jeanmoroski/Amazonian/tmp_imagens/exp02_a.jpg

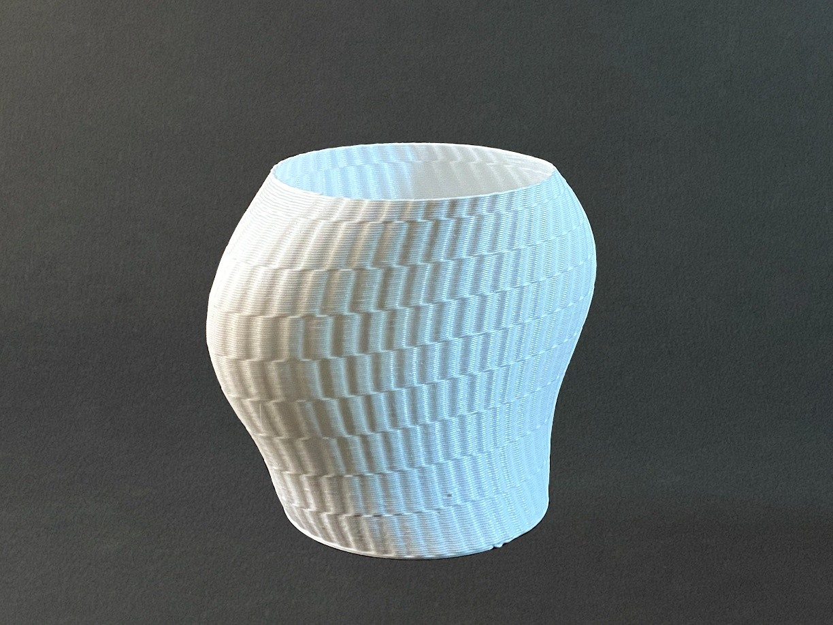
tmp_imagens/exp02_a.jpg
