jeanmoroski/Amazonian/tmp_imagens/exp13_a.jpg

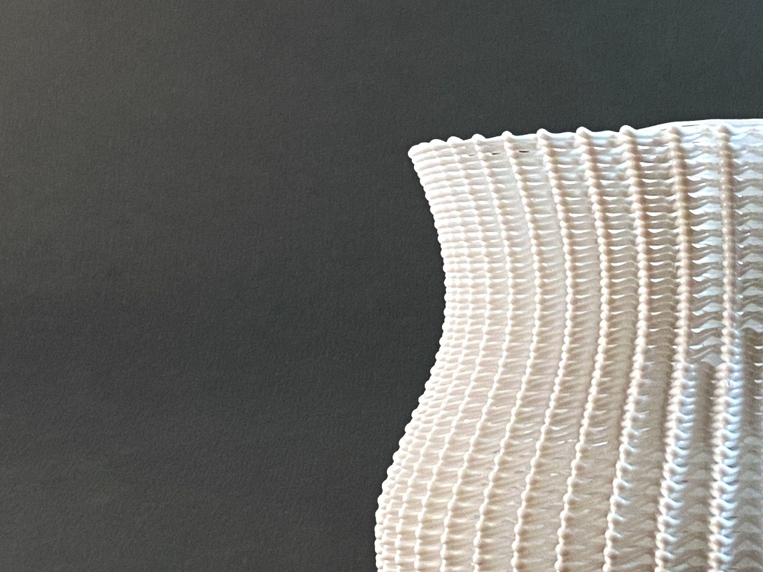
tmp_imagens/exp13_a.jpg
