jeanmoroski/Amazonian/tmp_imagens/exp01_a.jpg

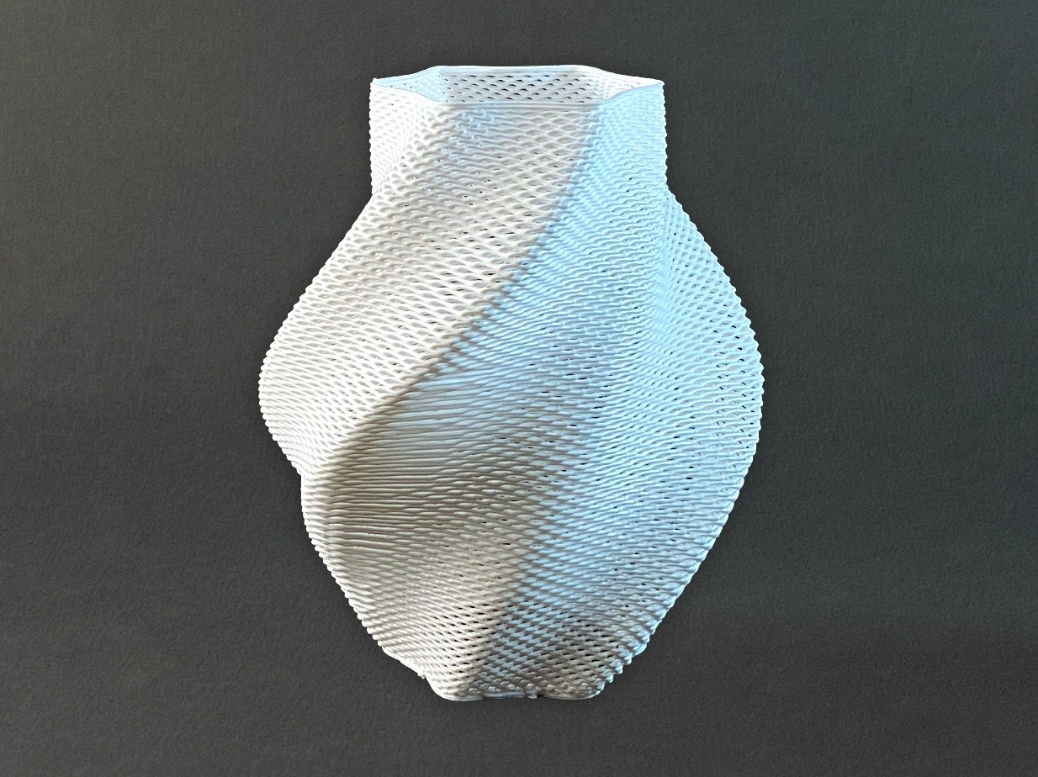
tmp_imagens/exp01_a.jpg
