jeanmoroski/Amazonian/tmp_imagens/exp01_b.jpg

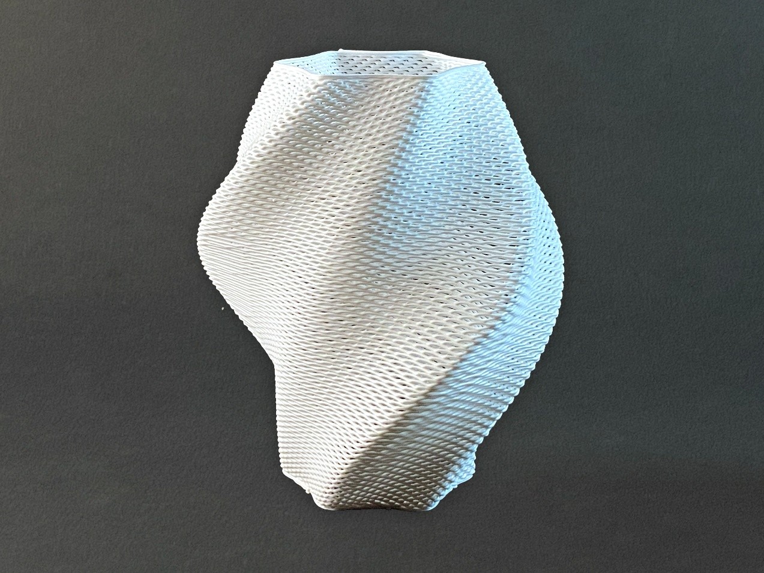
tmp_imagens/exp01_b.jpg
