jeanmoroski/Amazonian/tmp_imagens/exp02_b.jpg

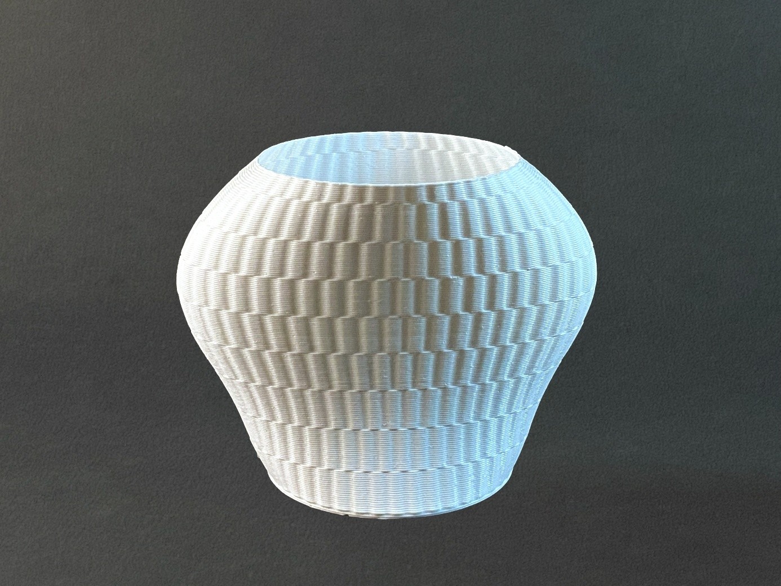
tmp_imagens/exp02_b.jpg
