jeanmoroski/Amazonian/tmp_imagens/exp03_a.jpg

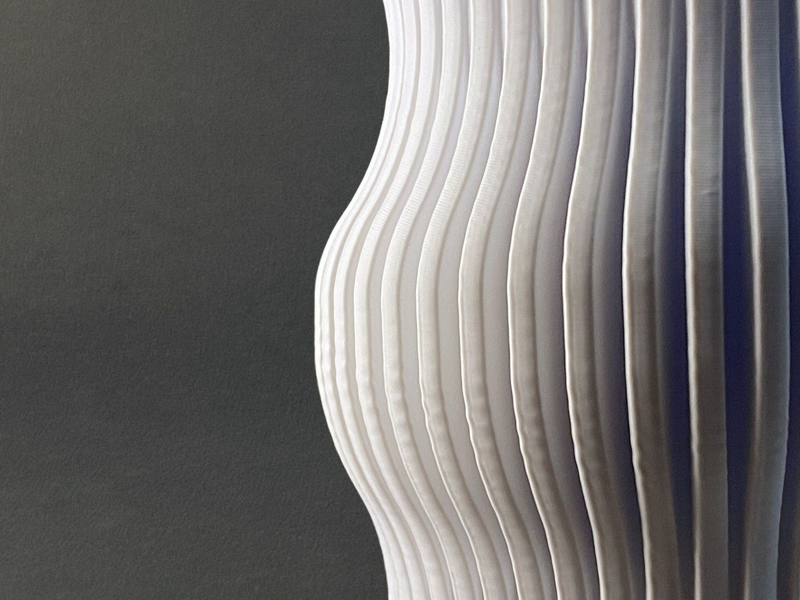
tmp_imagens/exp03_a.jpg
