jeanmoroski/Amazonian/tmp_imagens/exp03_b.jpg

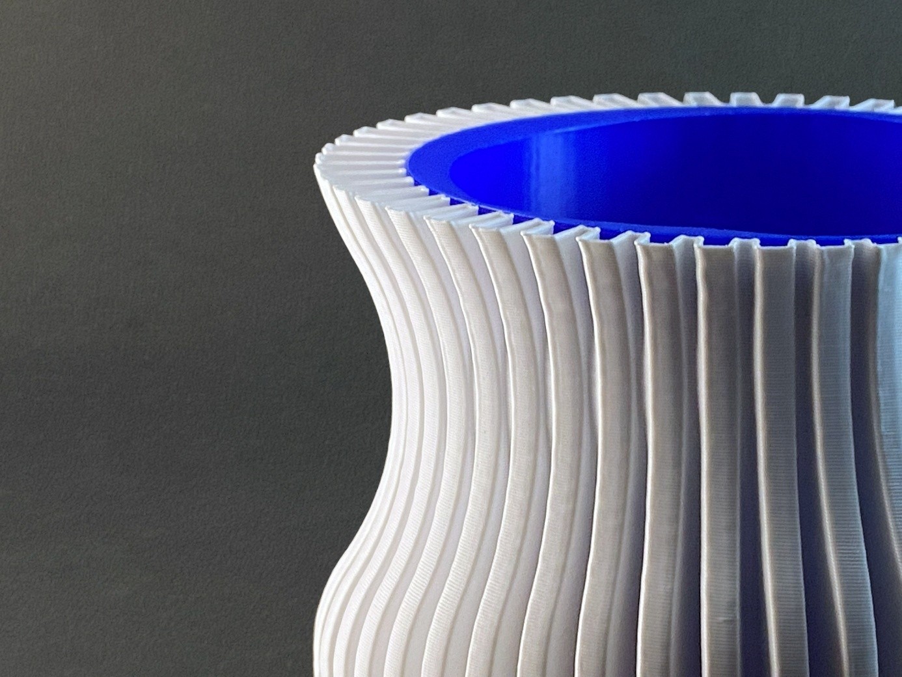
tmp_imagens/exp03_b.jpg
