jeanmoroski/Amazonian/tmp_imagens/exp04_a.jpg

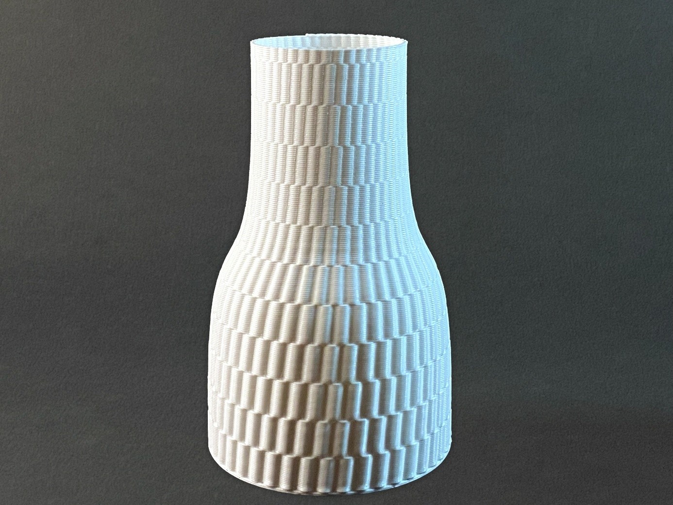
tmp_imagens/exp04_a.jpg
