jeanmoroski/Amazonian/tmp_imagens/exp05_a.jpg

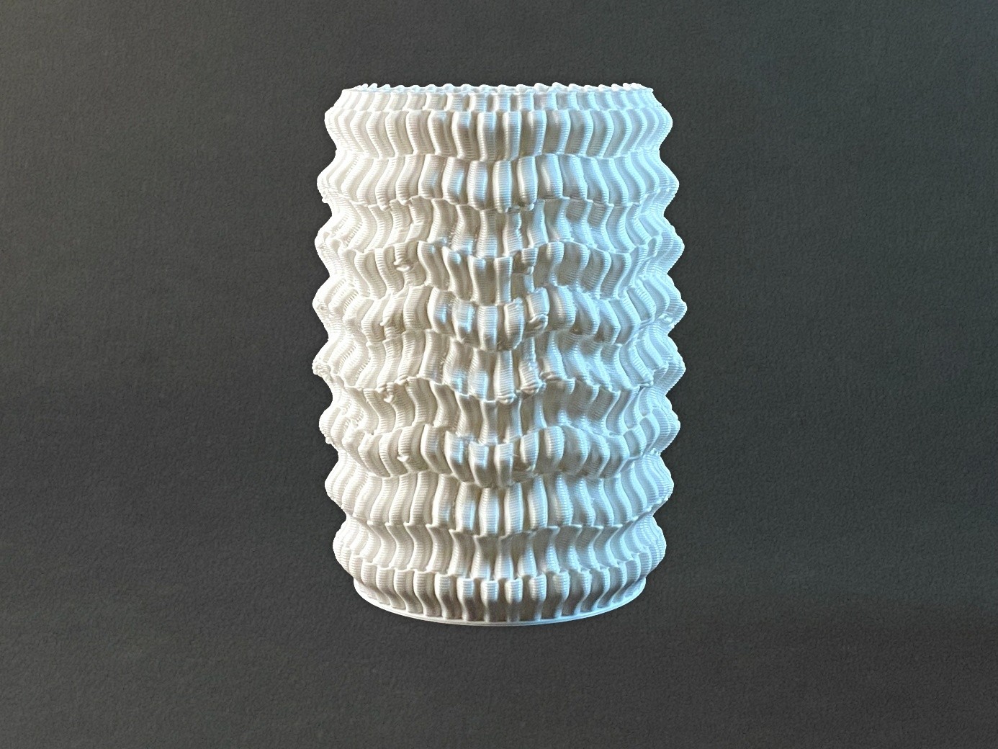
tmp_imagens/exp05_a.jpg
