jeanmoroski/Amazonian/tmp_imagens/exp06_a.jpg

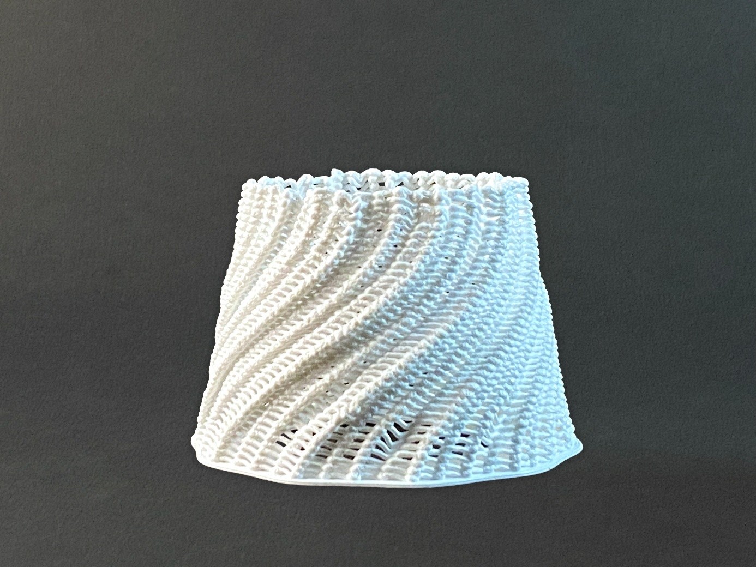
tmp_imagens/exp06_a.jpg
