jeanmoroski/Amazonian/tmp_imagens/exp07_a.jpg

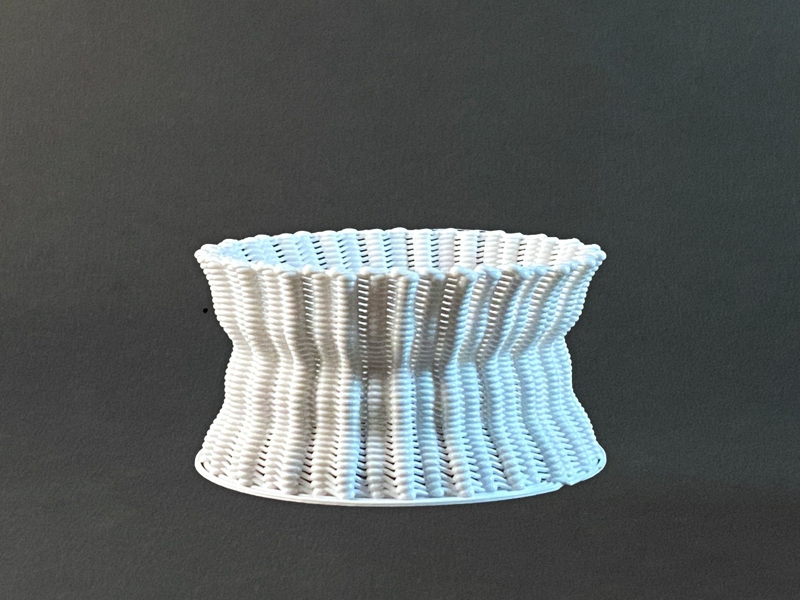
tmp_imagens/exp07_a.jpg
