jeanmoroski/Amazonian/tmp_imagens/exp08_a.jpg

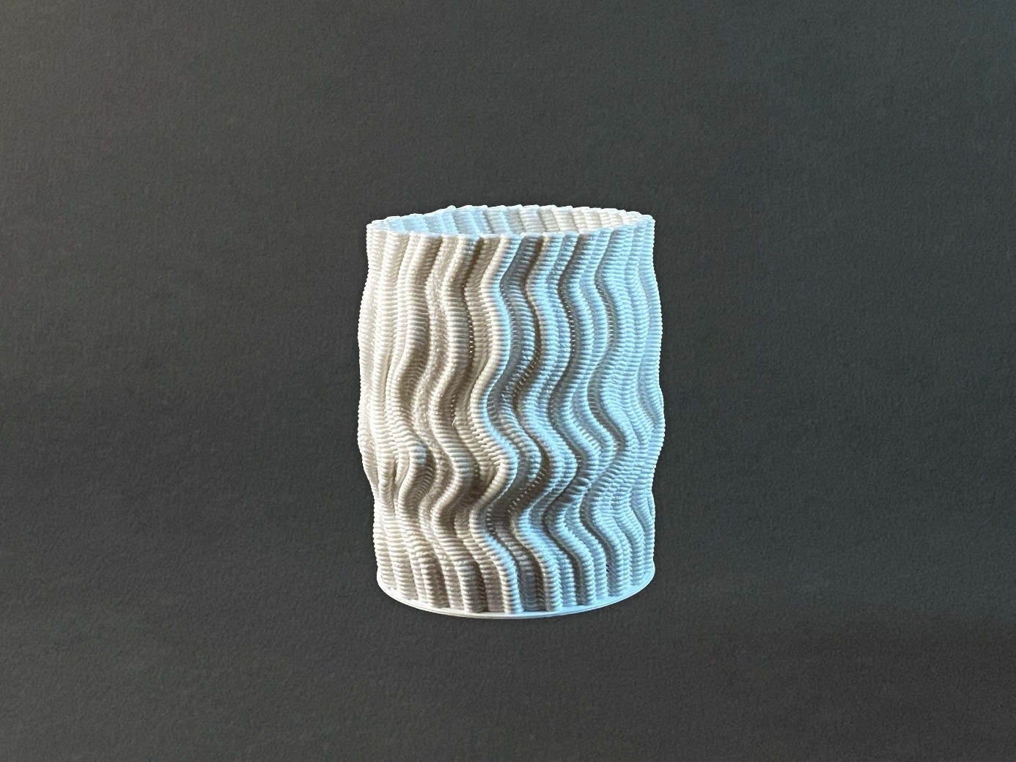
tmp_imagens/exp08_a.jpg
