jeanmoroski/Amazonian/tmp_imagens/exp09_a.jpg

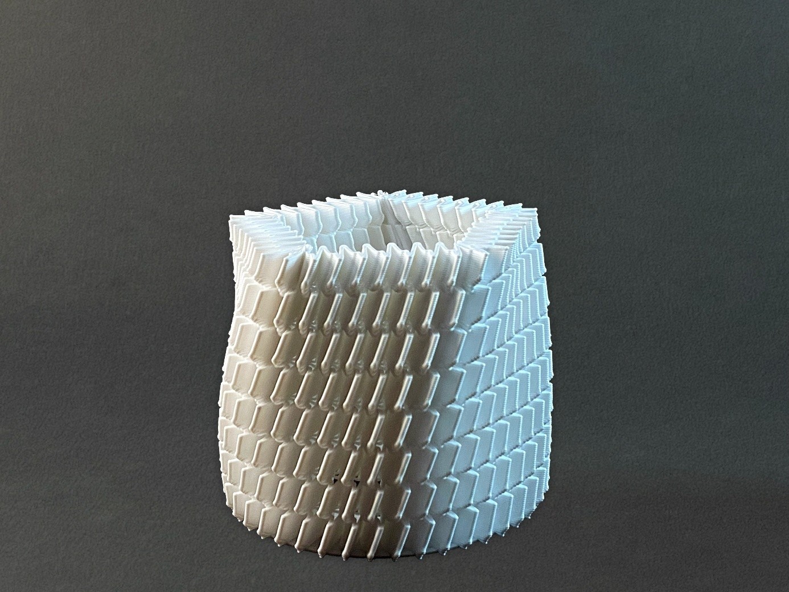
tmp_imagens/exp09_a.jpg
