jeanmoroski/Amazonian/tmp_imagens/exp10_a.jpg

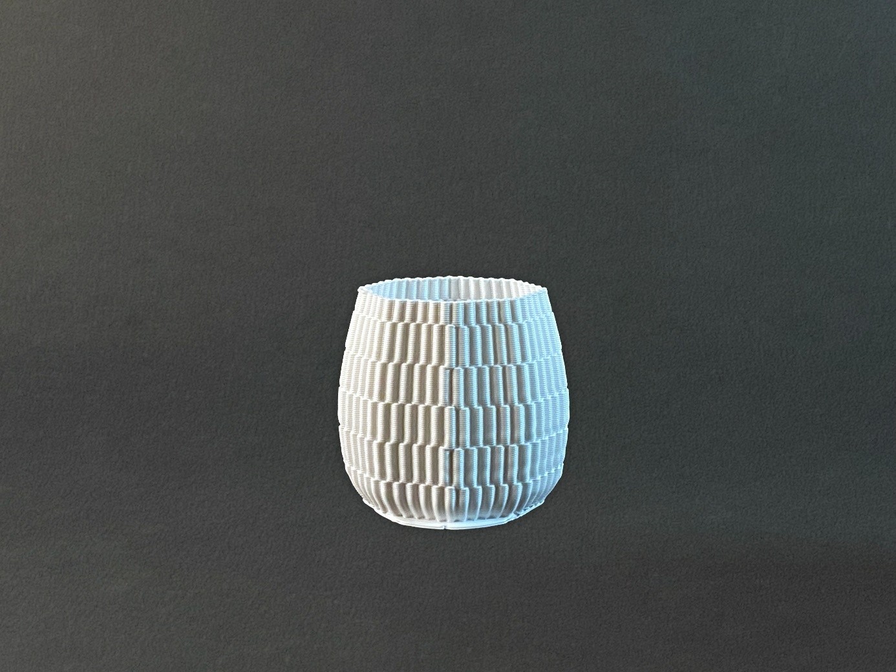
tmp_imagens/exp10_a.jpg
