jeanmoroski/Amazonian/tmp_imagens/exp11_a.jpg

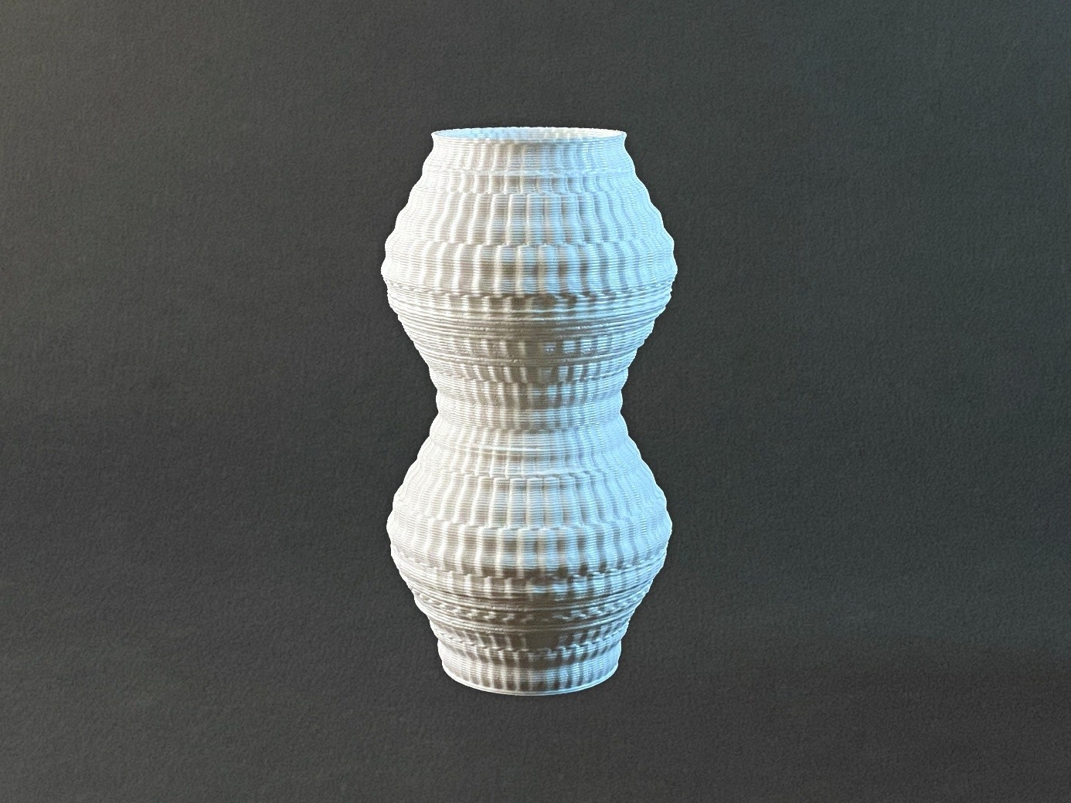
tmp_imagens/exp11_a.jpg
