jeanmoroski/Amazonian/tmp_imagens/exp12_a.jpg

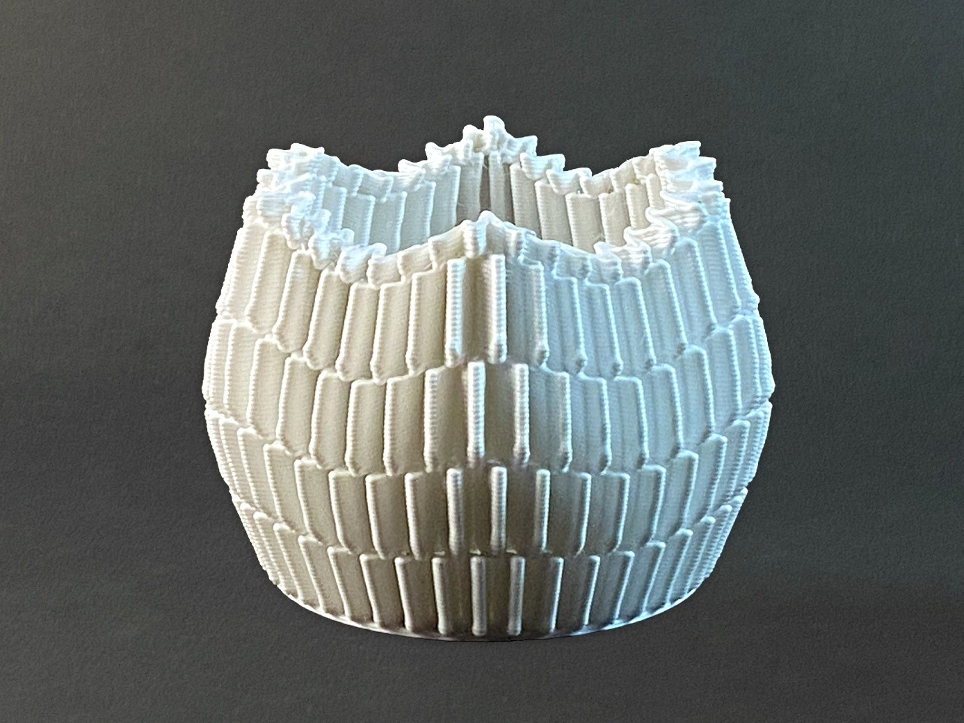
tmp_imagens/exp12_a.jpg
