jeanmoroski/Amazonian/tmp_imagens/exp13_b.jpg

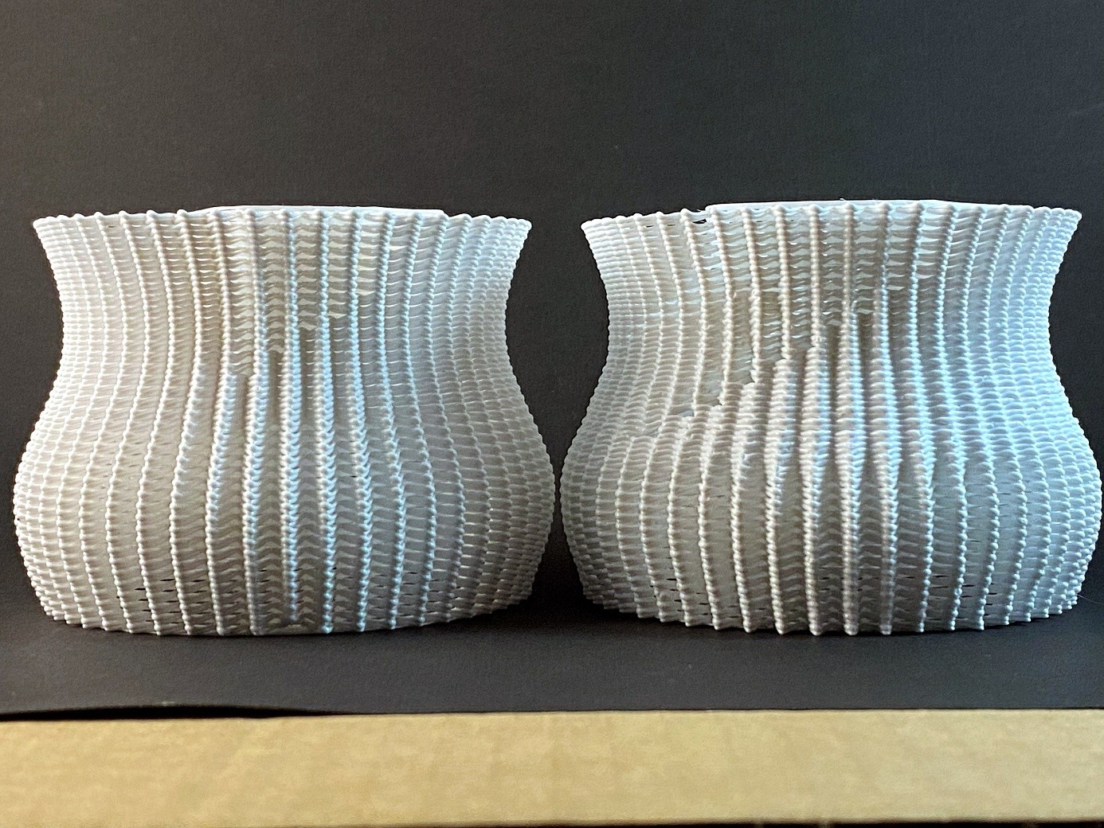
tmp_imagens/exp13_b.jpg
