jeanmoroski/Amazonian/tmp_imagens/exp15_a.jpg

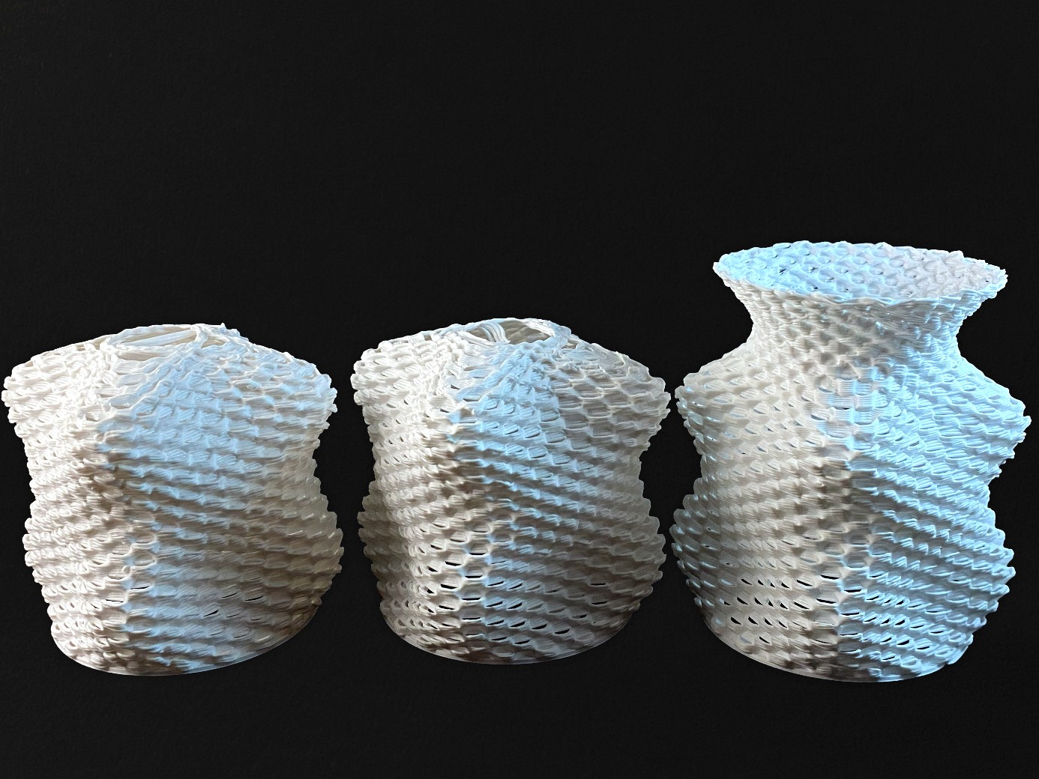
tmp_imagens/exp15_a.jpg
