jeanmoroski/Amazonian/tmp_imagens/exp15_b.jpg

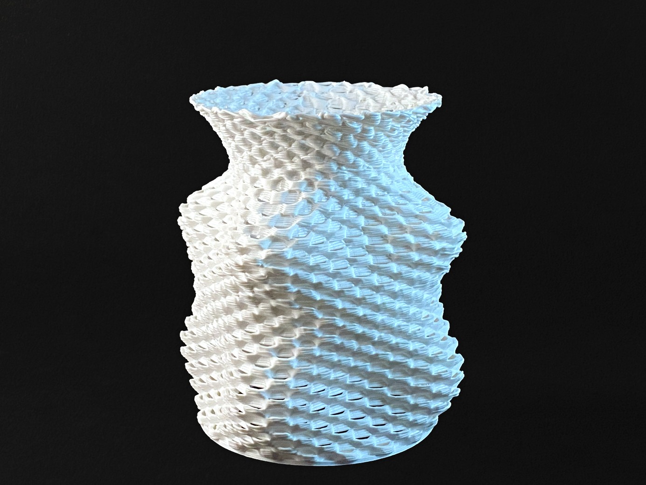
tmp_imagens/exp15_b.jpg
