jeanmoroski/Amazonian/tmp_imagens/exp16_a.jpg

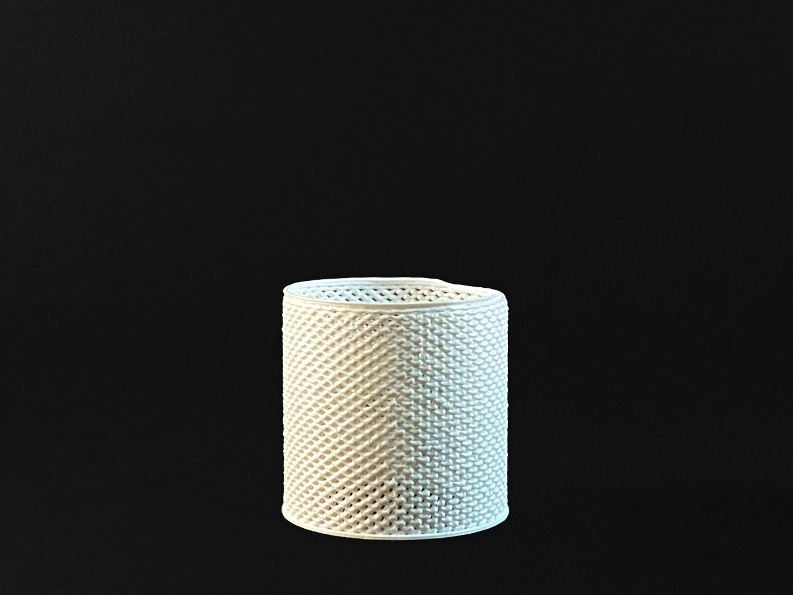
tmp_imagens/exp16_a.jpg
