jeanmoroski/Amazonian/tmp_imagens/exp17_a.jpg

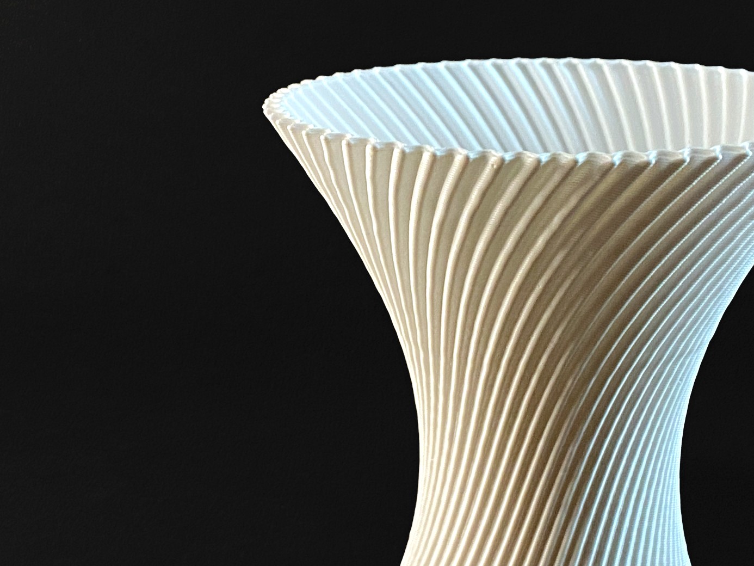
tmp_imagens/exp17_a.jpg
