jeanmoroski/Amazonian/tmp_imagens/exp17_b.jpg

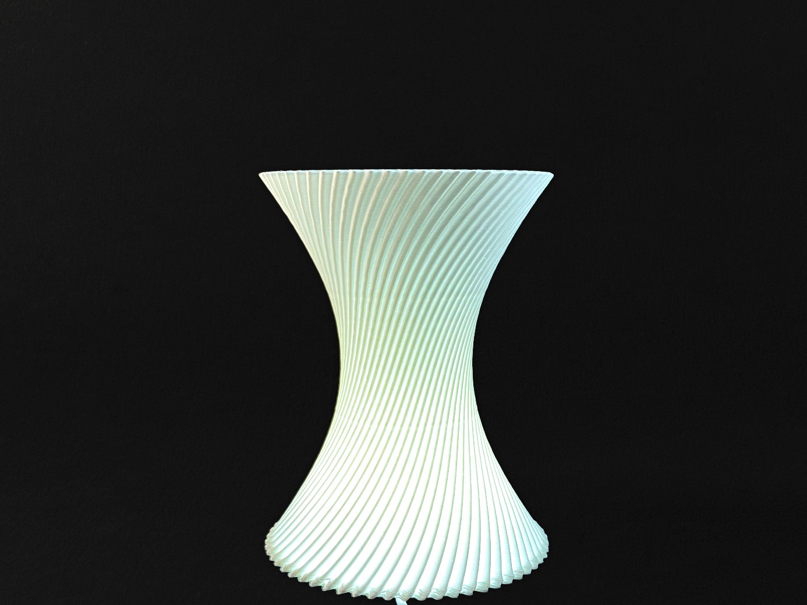
tmp_imagens/exp17_b.jpg
