jeanmoroski/Amazonian/tmp_imagens/exp18_a.jpg

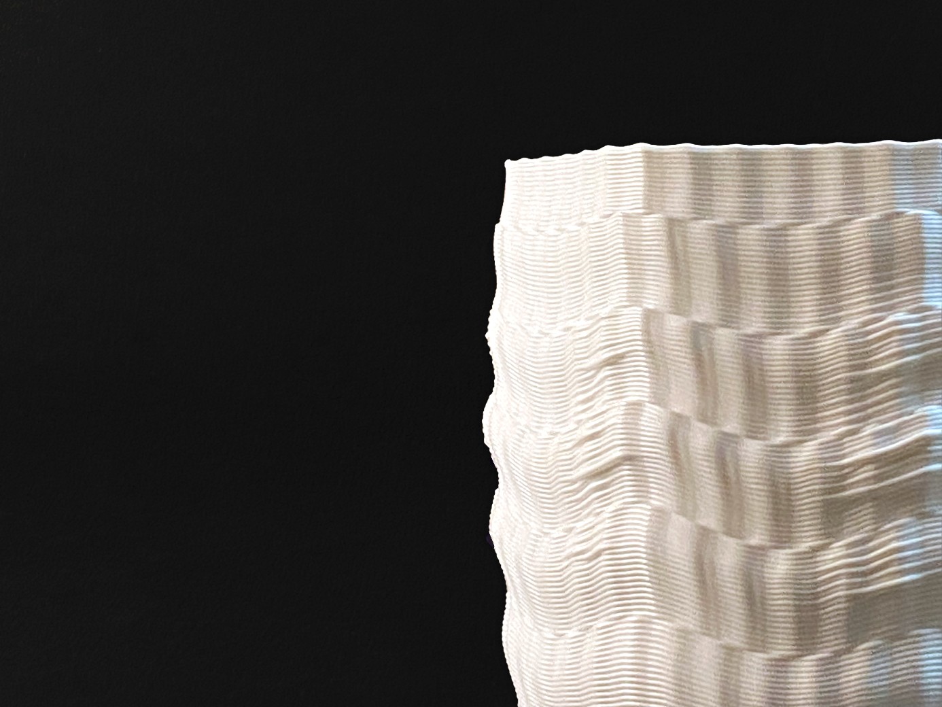
tmp_imagens/exp18_a.jpg
