jeanmoroski/Amazonian/tmp_imagens/exp19_a.jpg

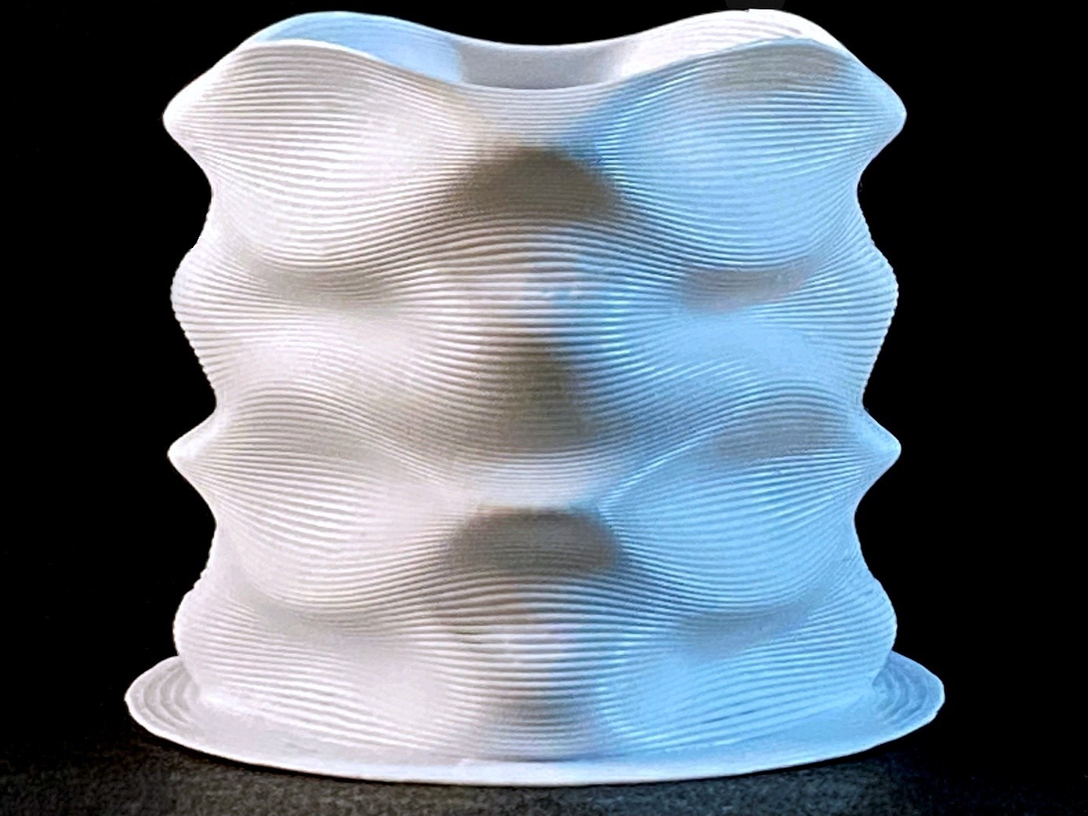
tmp_imagens/exp19_a.jpg
