jeanmoroski/Amazonian/tmp_imagens/exp19_b.jpg

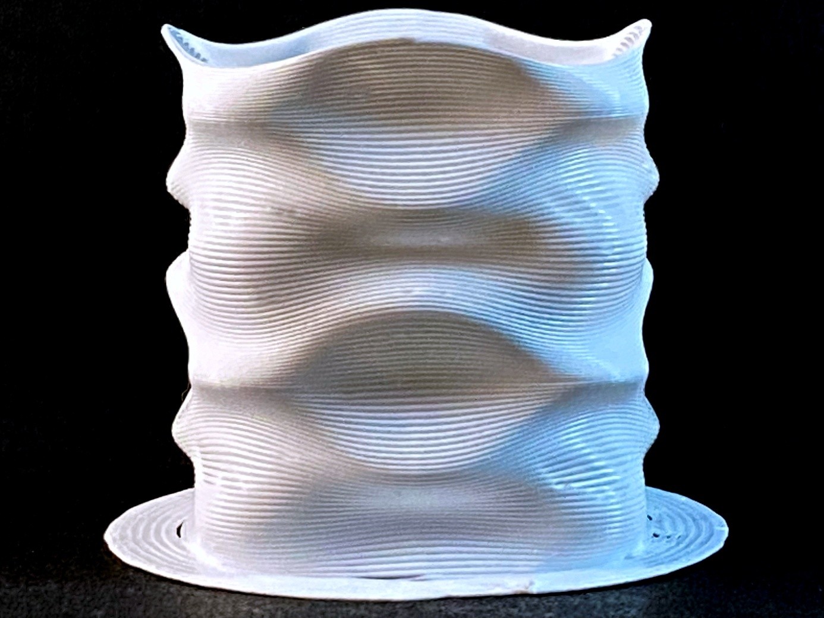
tmp_imagens/exp19_b.jpg
