jeanmoroski/Amazonian/tmp_imagens/exp20_a.jpg

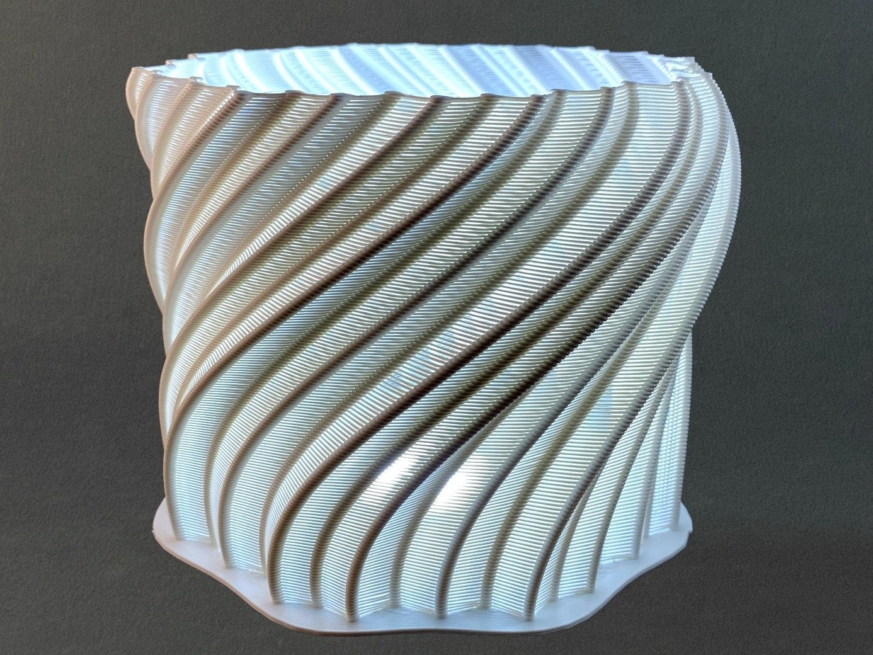
tmp_imagens/exp20_a.jpg
