jeanmoroski/Amazonian/tmp_imagens/exp20_b.jpg

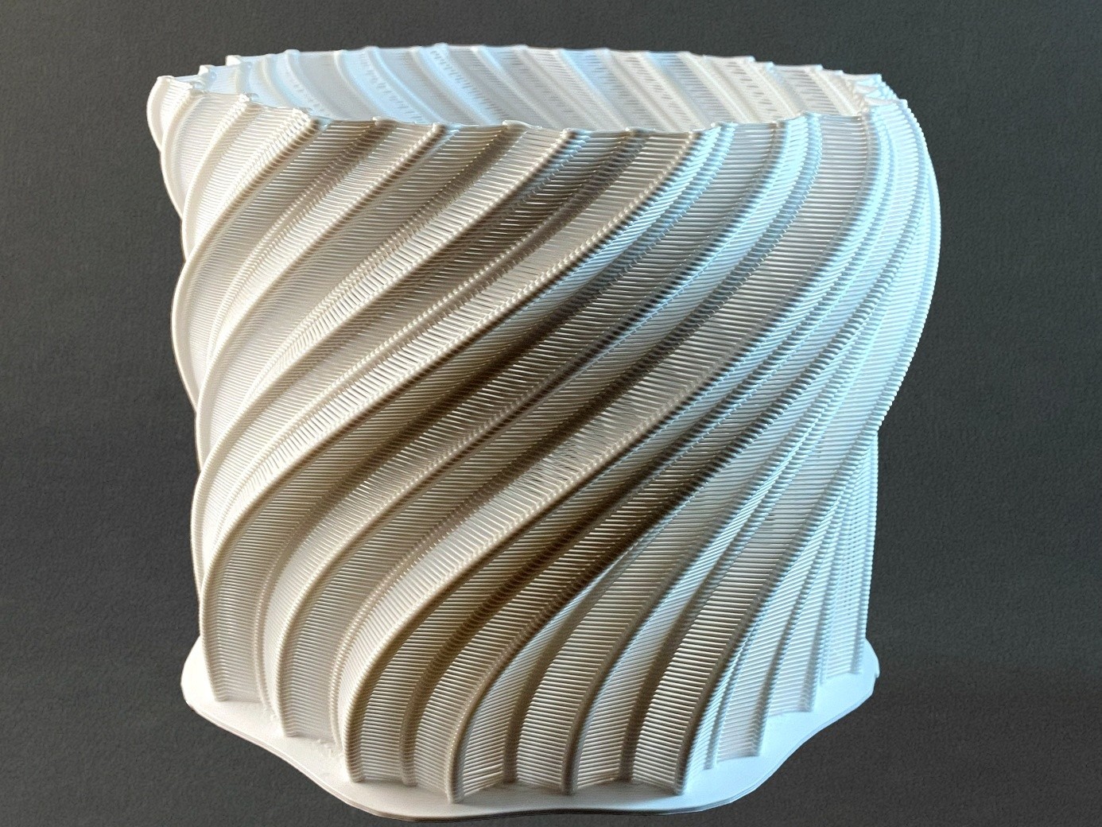
tmp_imagens/exp20_b.jpg
