jeanmoroski/Amazonian/pranchaTecnica.pdf

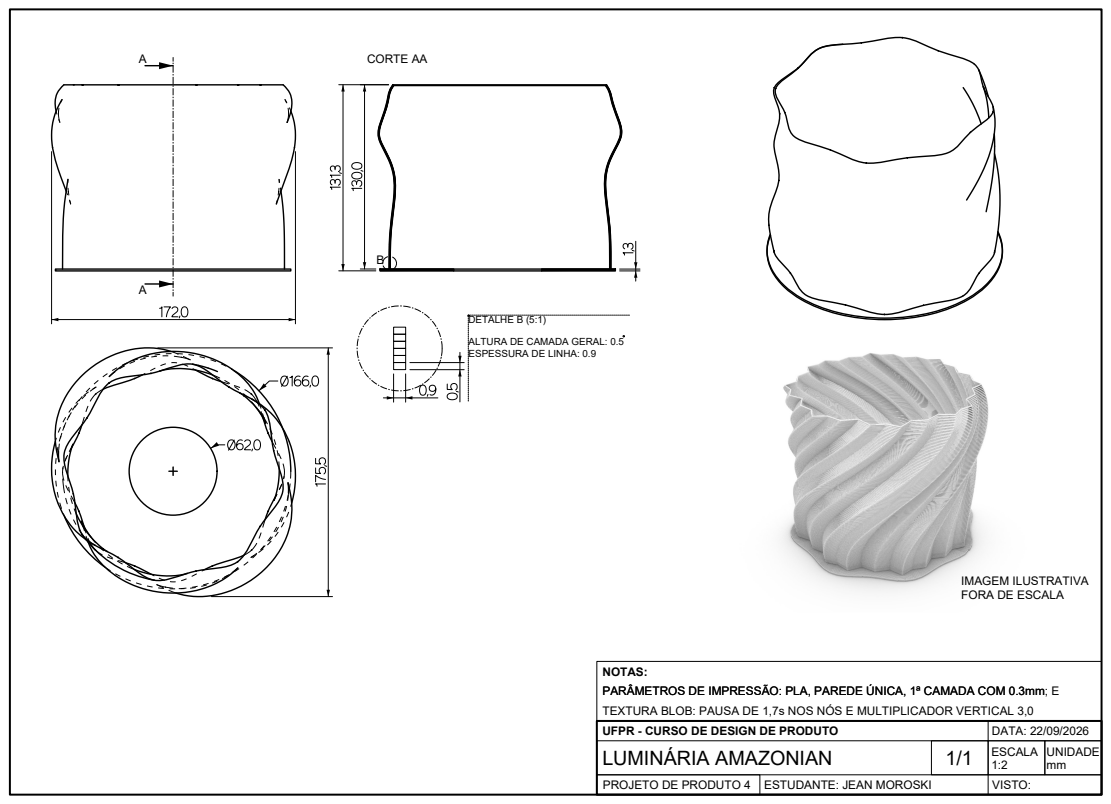
[picture p28: page 1]
CORTE AA; DETALHE B (5:1); UFPR - CURSO DE DESIGN DE PRODUTO; DATA: 22/09/2026; ESCALA 1:2; UNIDADE mm; VISTO:; LUMINÁRIA AMAZONIAN

ALTURA DE CAMADA GERAL: 0.5
ESPESSURA DE LINHA: 0.9

IMAGEM ILUSTRATIVA
FORA DE ESCALA

NOTAS:
PARÂMETROS DE IMPRESSÃO: PLA, PAREDE ÚNICA, 1ª CAMADA COM 0.3mm; E
TEXTURA BLOB: PAUSA DE 1,7s NOS NÓS E MULTIPLICADOR VERTICAL 3,0

PARÂMETROS DE IMPRESSÃO: PLA, PAREDE ÚNICA, 1ª CAMADA COM 0.3mm

PROJETO DE PRODUTO 4 ESTUDANTE: JEAN MOROSKI
